The0ldM0nk/Locator2/Pictures/Pro Mini Soldered.jpg

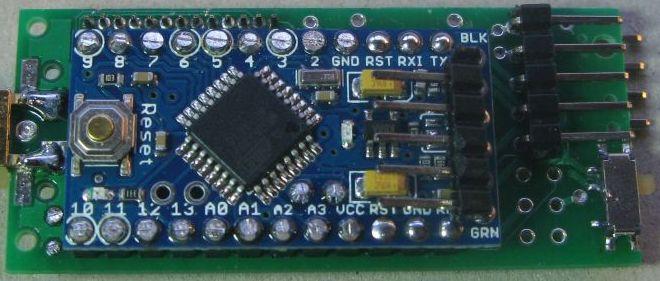
Pictures/Pro Mini Soldered.jpg
