The0ldM0nk/Locator2/Pictures/IMG_0867.JPG

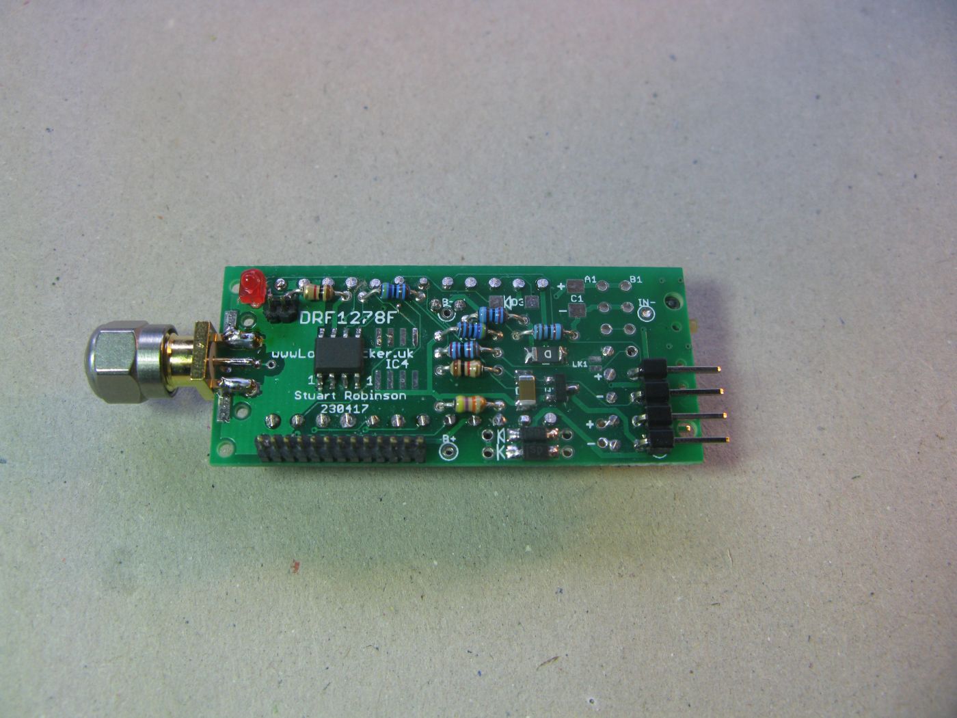
Pictures/IMG_0867.JPG
