The0ldM0nk/Locator2/Pictures/5 pin power header.jpg

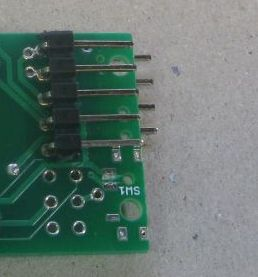
Pictures/5 pin power header.jpg
