The0ldM0nk/Locator2/Pictures/20x4 LCD Display Reduced.jpg

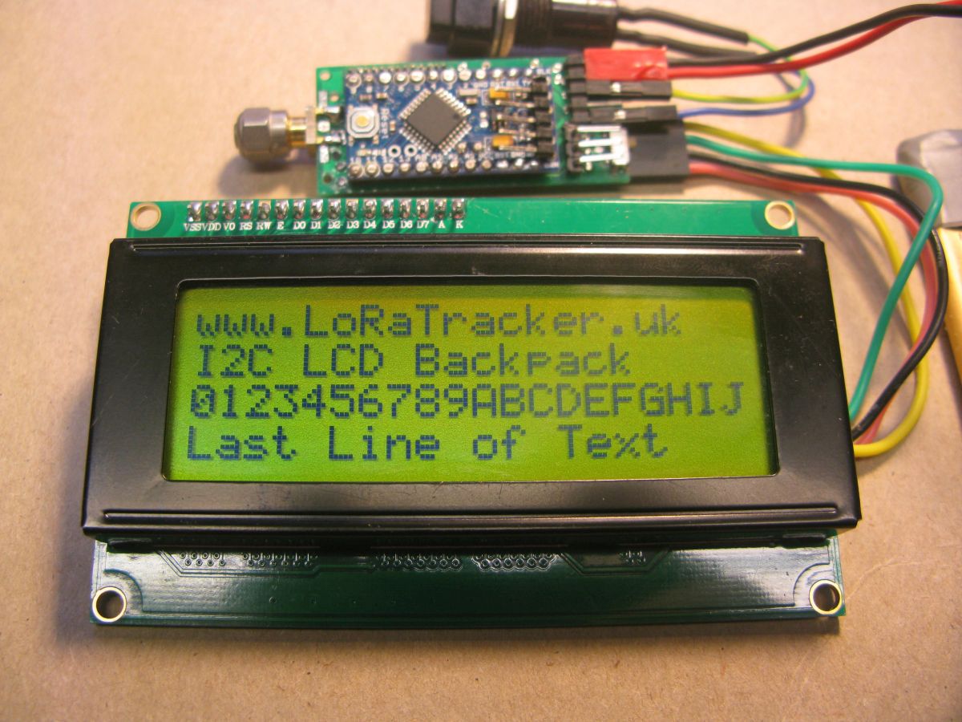
Pictures/20x4 LCD Display Reduced.jpg
