The0ldM0nk/Locator2/Pictures/GPS Connection.jpg

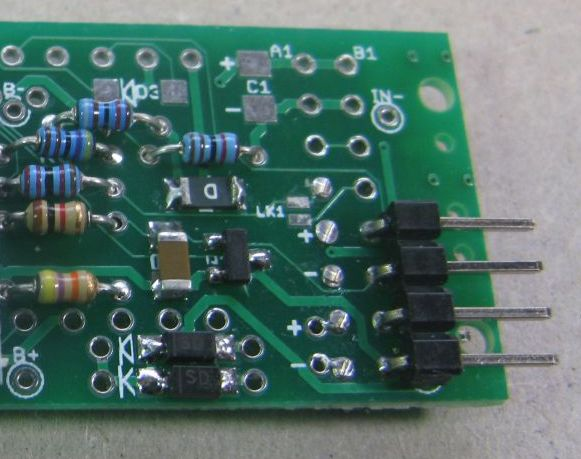
Pictures/GPS Connection.jpg
