The0ldM0nk/Locator2/Pictures/GPS header.jpg

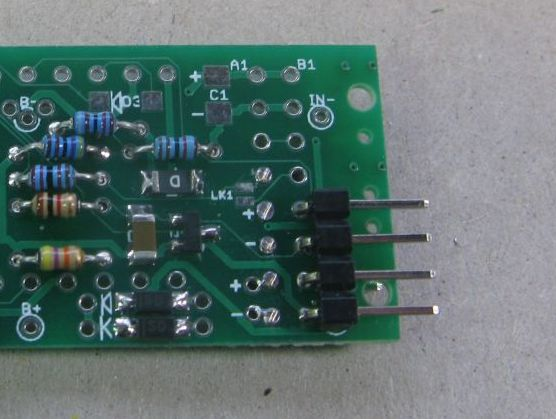
Pictures/GPS header.jpg
