The0ldM0nk/Locator2/Pictures/IMG_0831.JPG

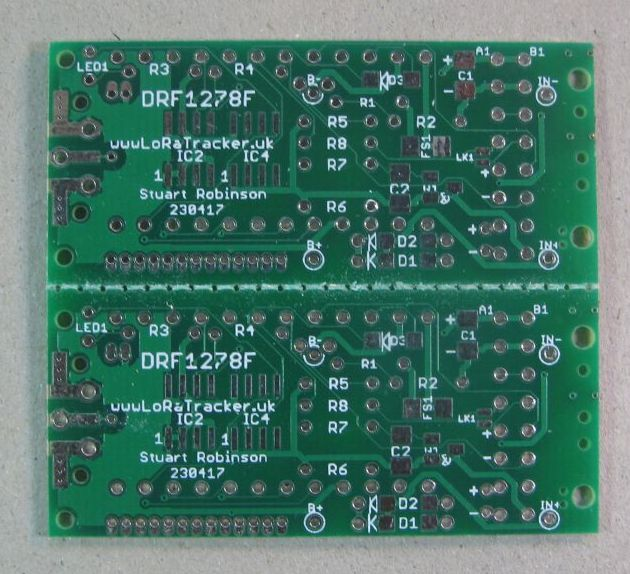
Pictures/IMG_0831.JPG
