The0ldM0nk/Locator2/Pictures/IMG_0835.JPG

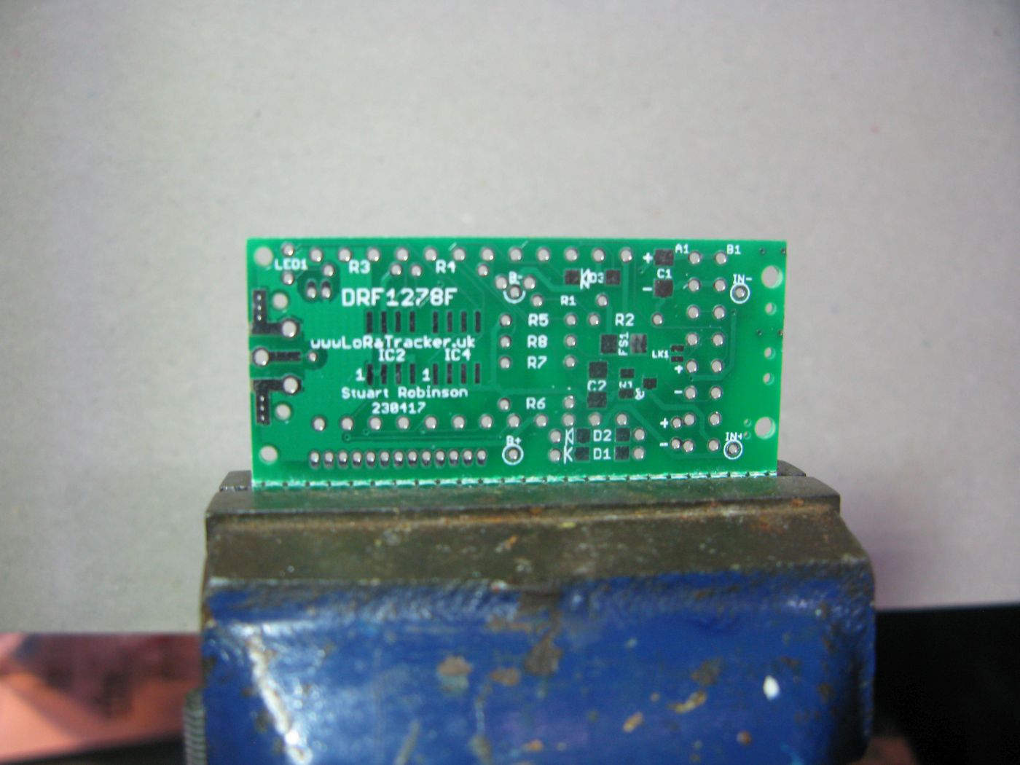
Pictures/IMG_0835.JPG
