The0ldM0nk/Locator2/Pictures/IMG_0836.JPG

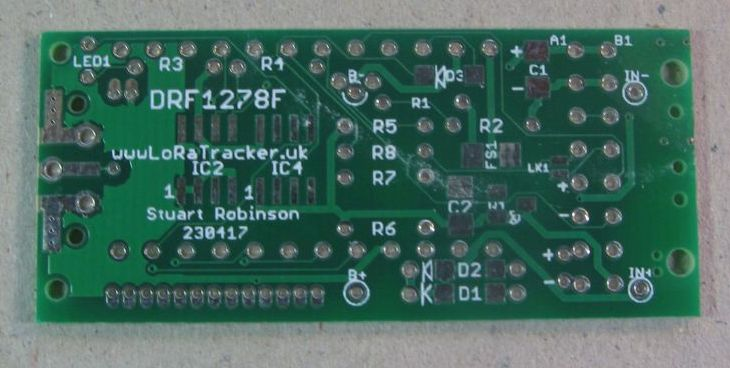
Pictures/IMG_0836.JPG
