The0ldM0nk/Locator2/Pictures/IMG_0838.JPG

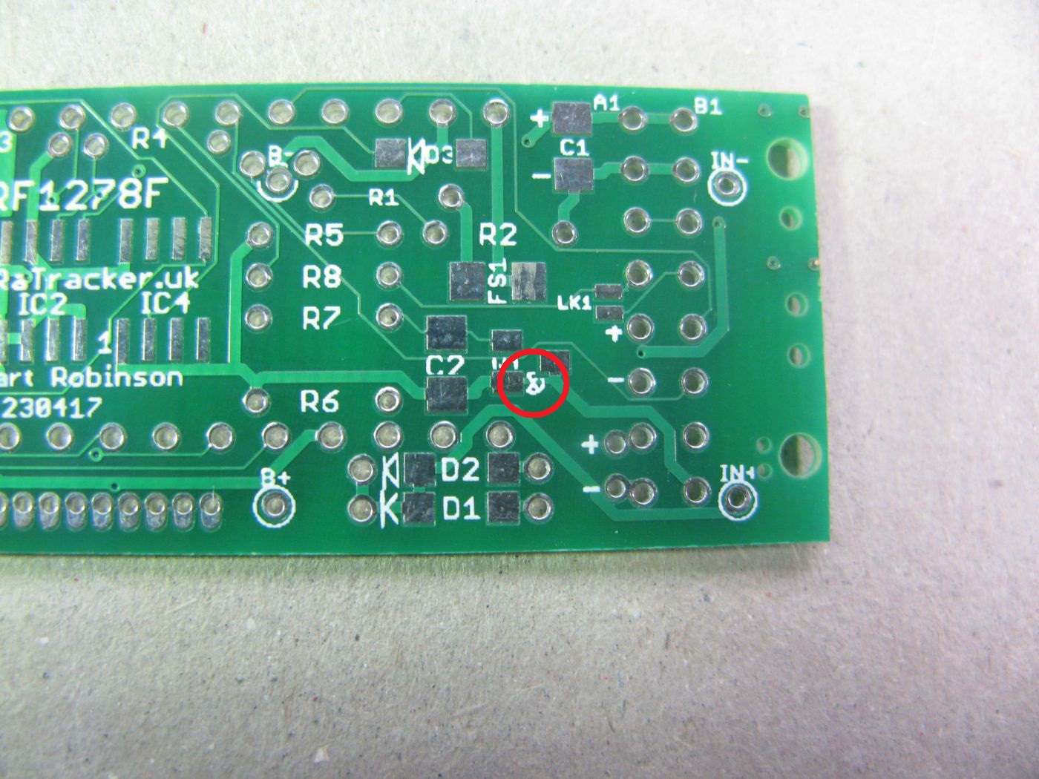
Pictures/IMG_0838.JPG
