The0ldM0nk/Locator2/Pictures/IMG_0840.JPG

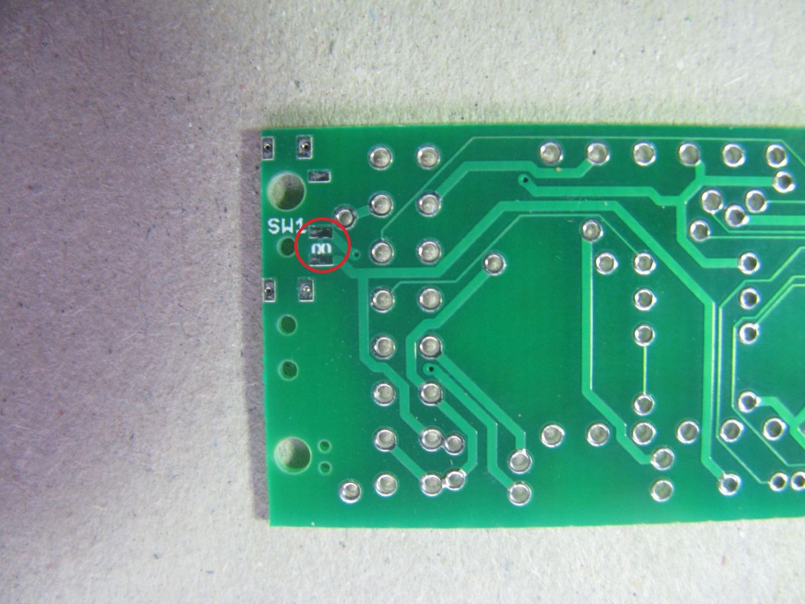
Pictures/IMG_0840.JPG
