The0ldM0nk/Locator2/Pictures/IMG_0843.JPG

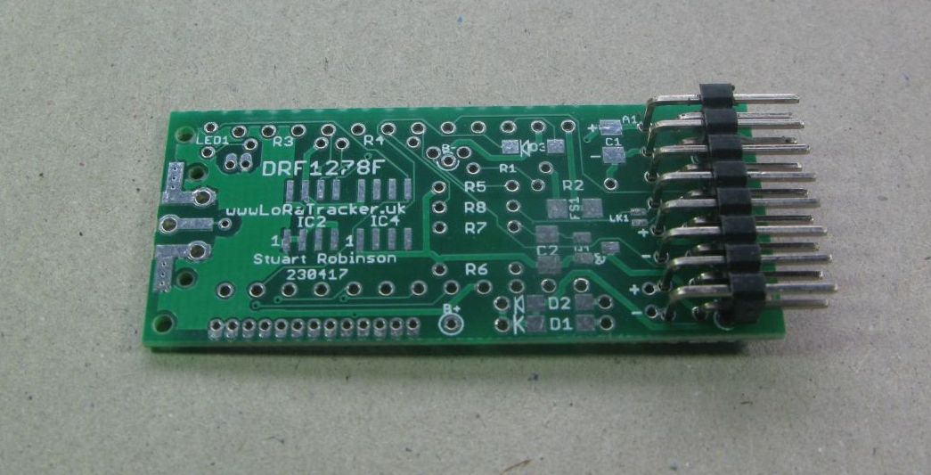
Pictures/IMG_0843.JPG
