The0ldM0nk/Locator2/Pictures/IMG_0844.JPG

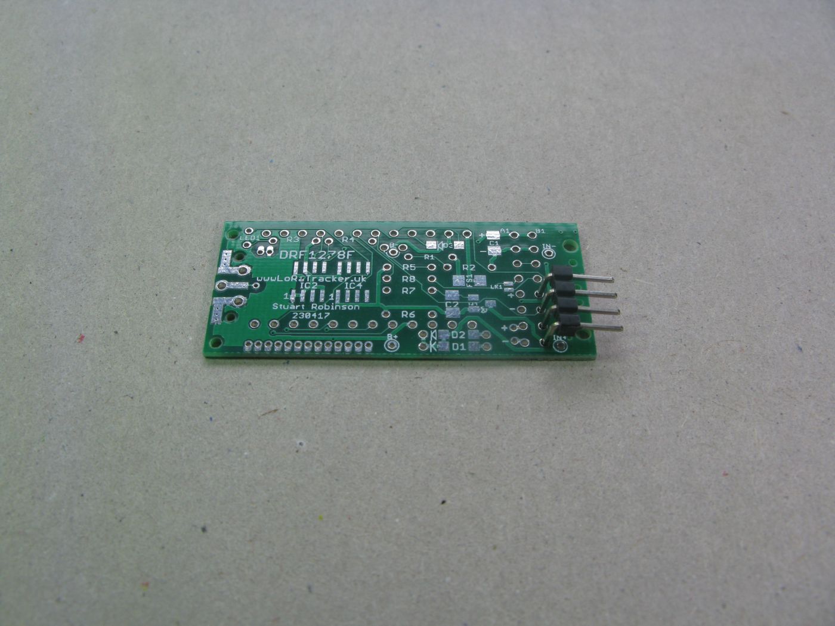
Pictures/IMG_0844.JPG
