The0ldM0nk/Locator2/Pictures/IMG_0846.JPG

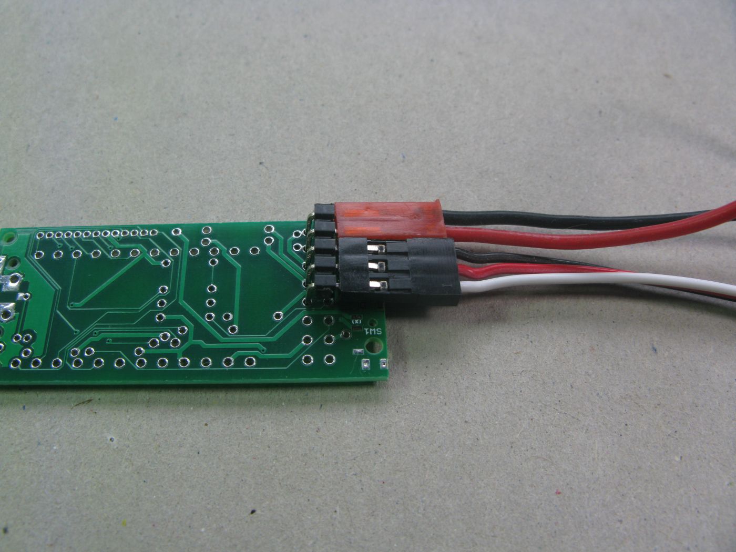
Pictures/IMG_0846.JPG
