The0ldM0nk/Locator2/Pictures/IMG_0847.JPG

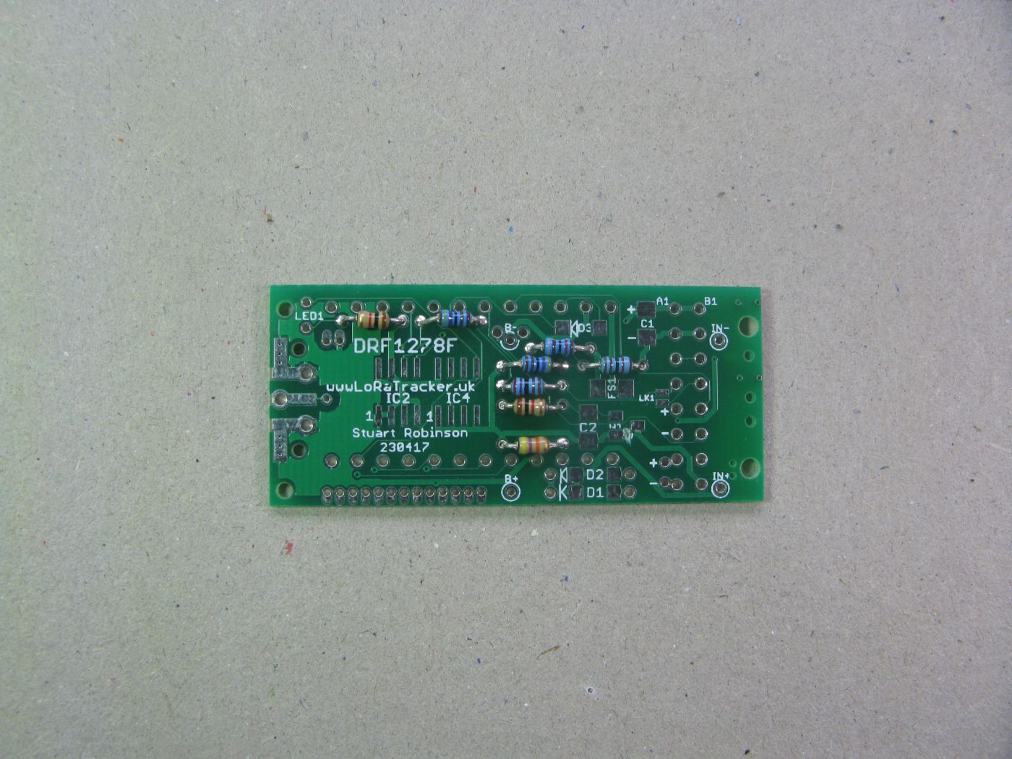
Pictures/IMG_0847.JPG
