The0ldM0nk/Locator2/Pictures/IMG_0850.JPG

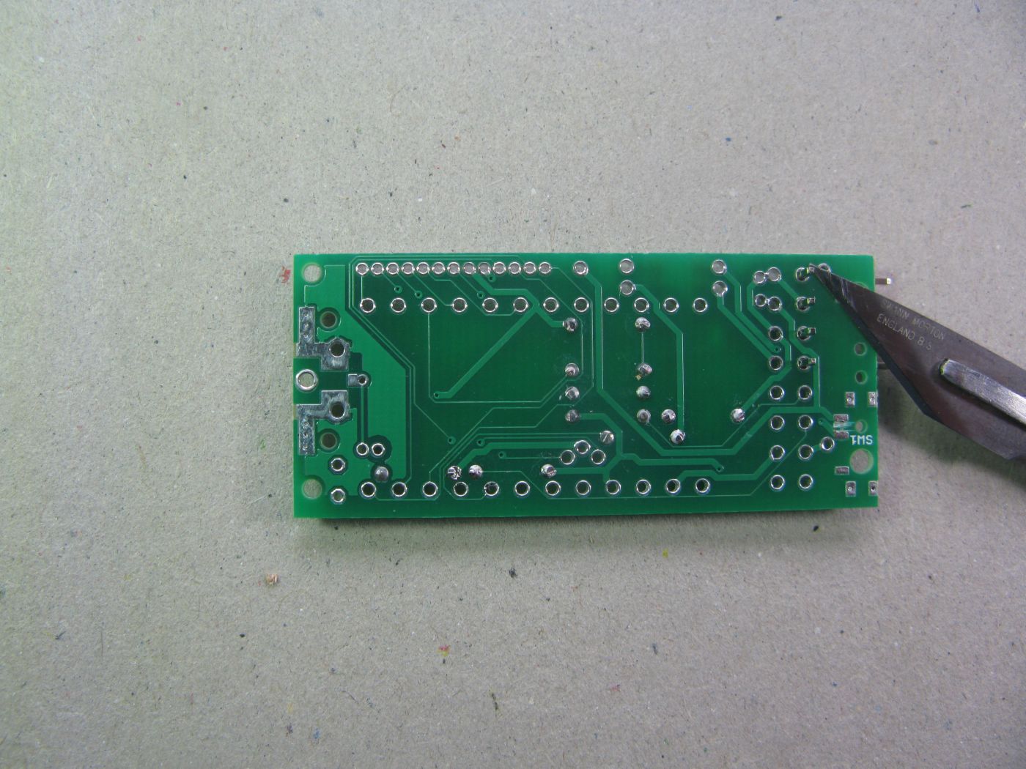
Pictures/IMG_0850.JPG
