The0ldM0nk/Locator2/Pictures/IMG_0851.JPG

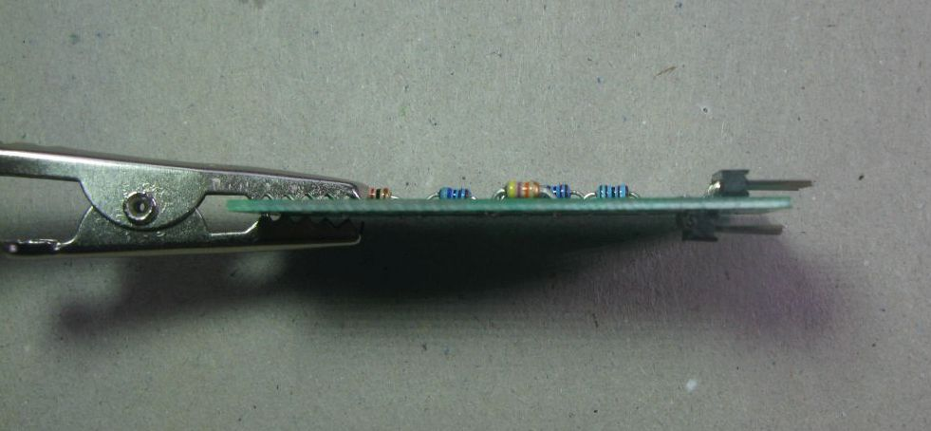
Pictures/IMG_0851.JPG
