The0ldM0nk/Locator2/Pictures/IMG_0853.JPG

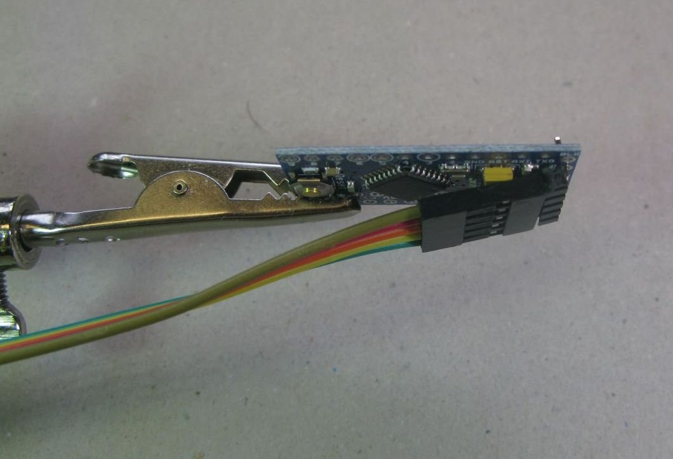
Pictures/IMG_0853.JPG
