The0ldM0nk/Locator2/Pictures/IMG_0857.JPG

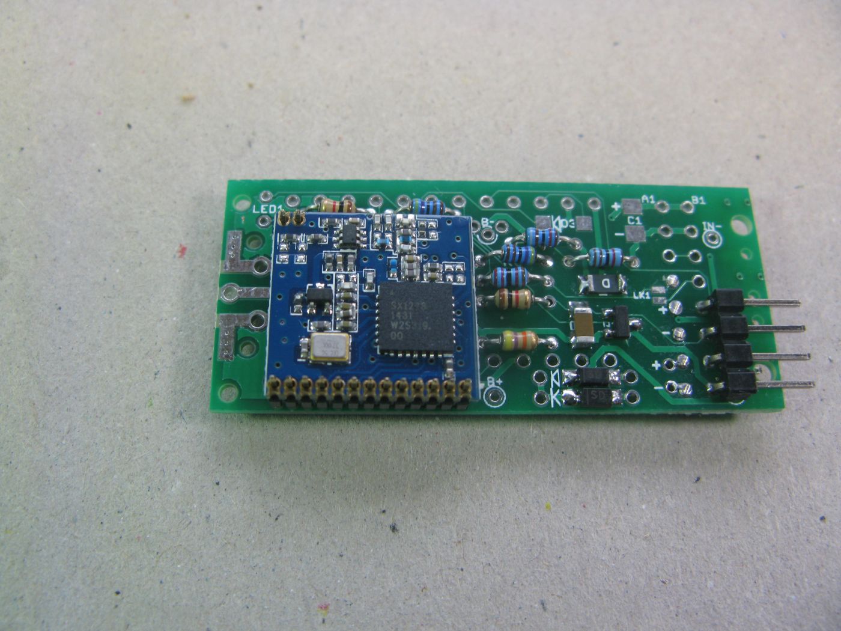
Pictures/IMG_0857.JPG
