The0ldM0nk/Locator2/Pictures/IMG_0859.JPG

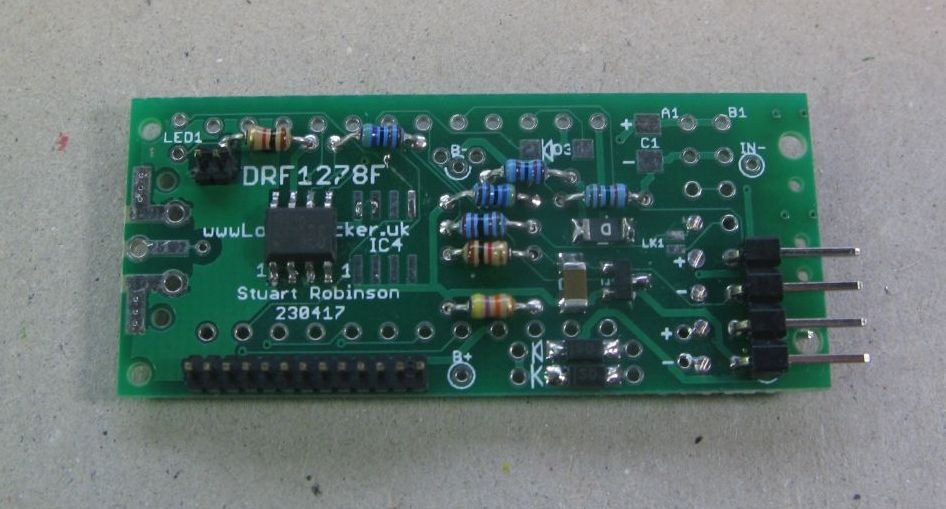
Pictures/IMG_0859.JPG
