The0ldM0nk/Locator2/Pictures/IMG_0860.JPG

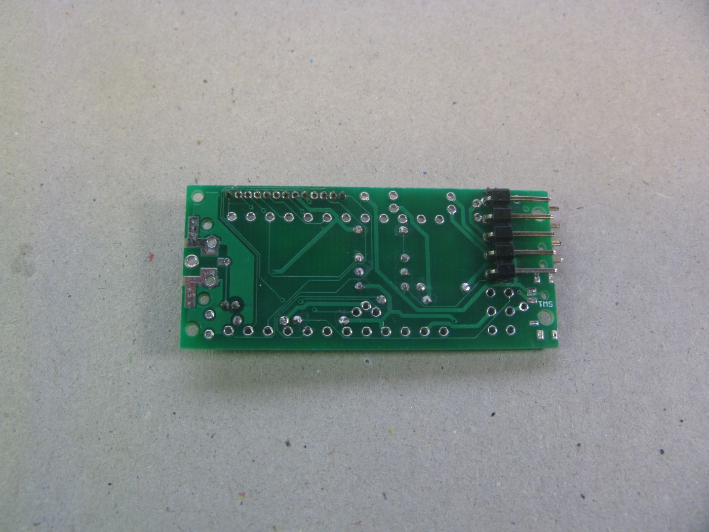
Pictures/IMG_0860.JPG
