The0ldM0nk/Locator2/Pictures/IMG_0861.JPG

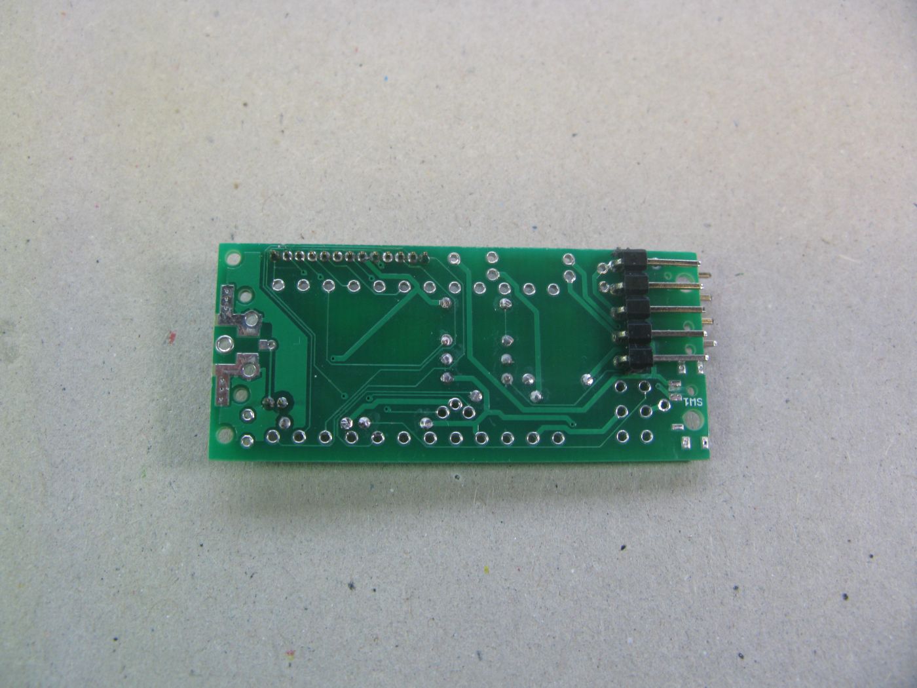
Pictures/IMG_0861.JPG
