The0ldM0nk/Locator2/Pictures/IMG_0864.JPG

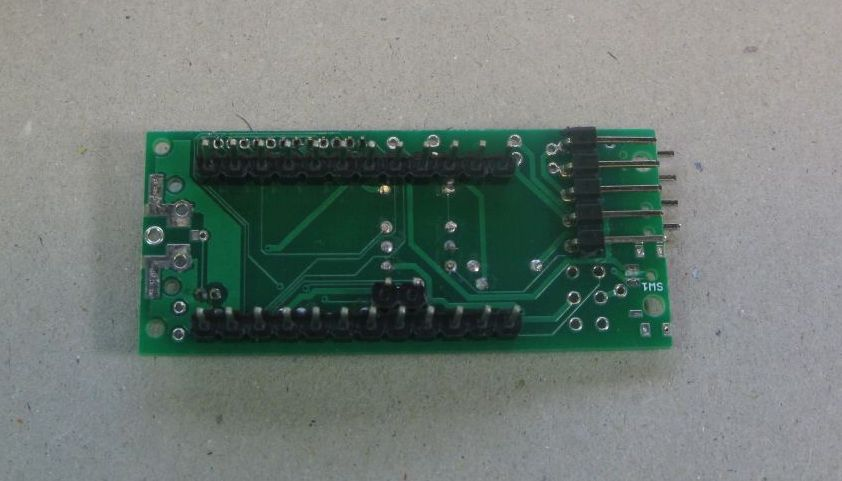
Pictures/IMG_0864.JPG
