The0ldM0nk/Locator2/Pictures/IMG_0865.JPG

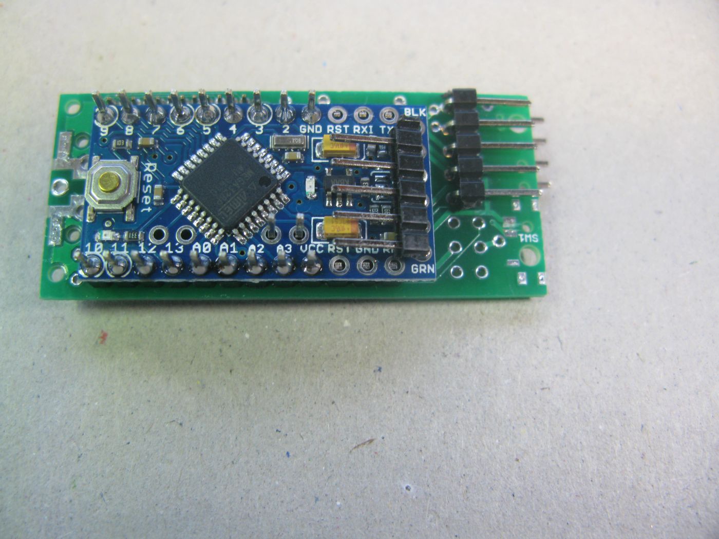
Pictures/IMG_0865.JPG
