The0ldM0nk/Locator2/Pictures/IMG_0869.JPG

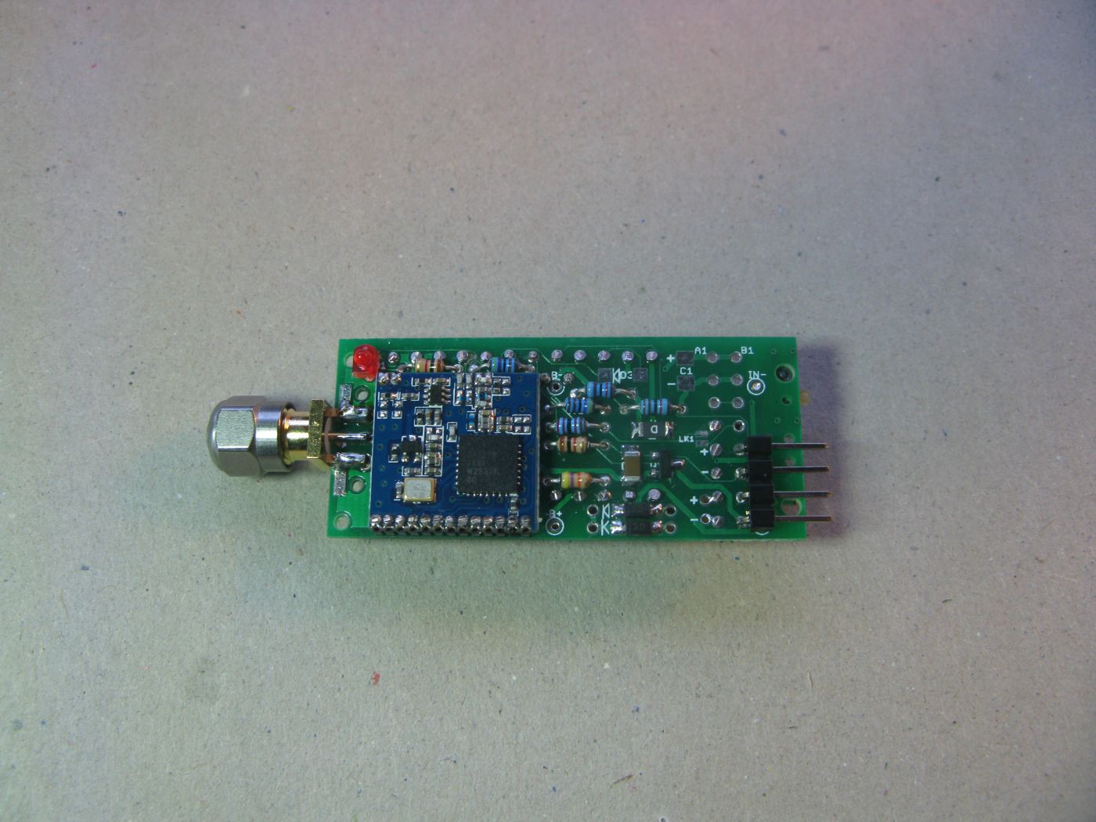
Pictures/IMG_0869.JPG
