The0ldM0nk/Locator2/Pictures/IMG_0870.JPG

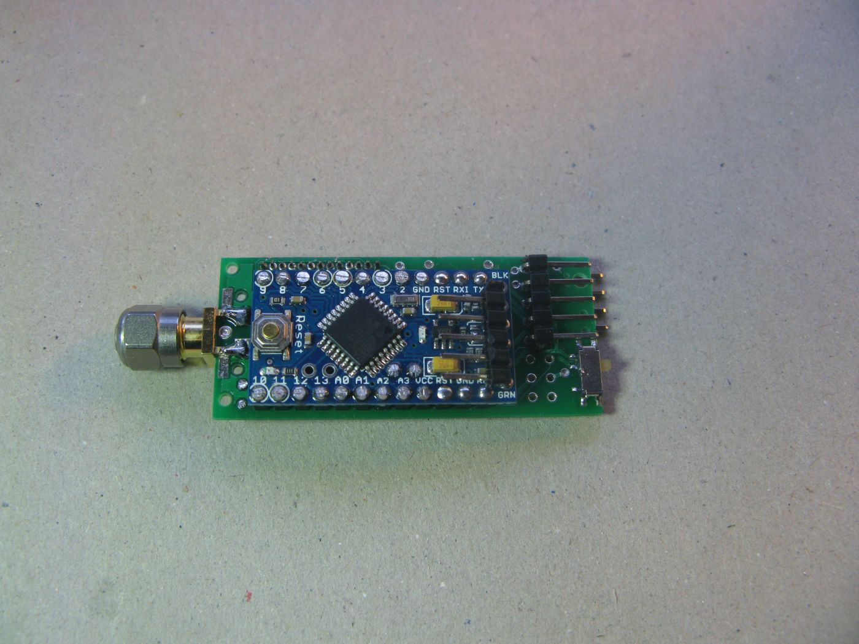
Pictures/IMG_0870.JPG
