The0ldM0nk/Locator2/Pictures/IMG_0953.JPG

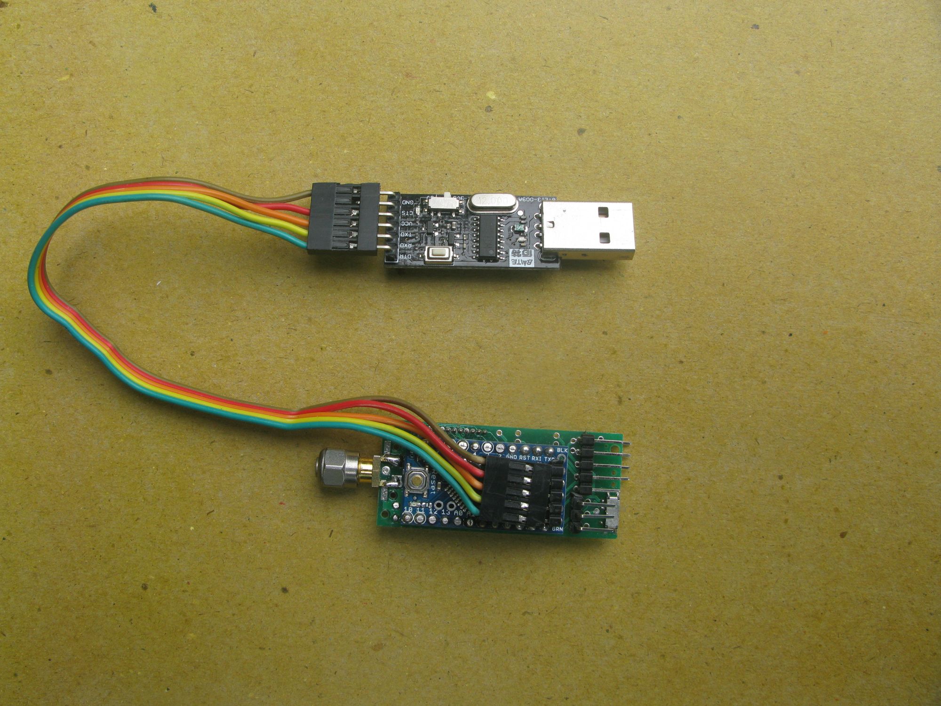
Pictures/IMG_0953.JPG
