The0ldM0nk/Locator2/Pictures/IMG_0956.JPG

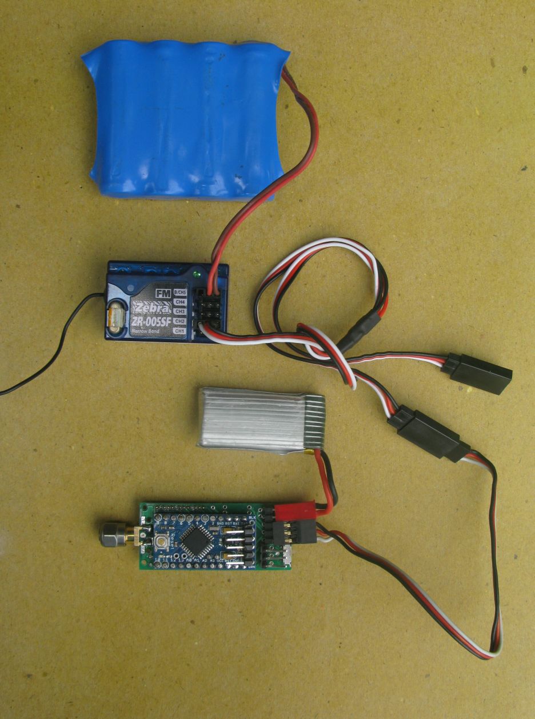
Pictures/IMG_0956.JPG
