The0ldM0nk/Locator2/Pictures/IMG_0960.JPG

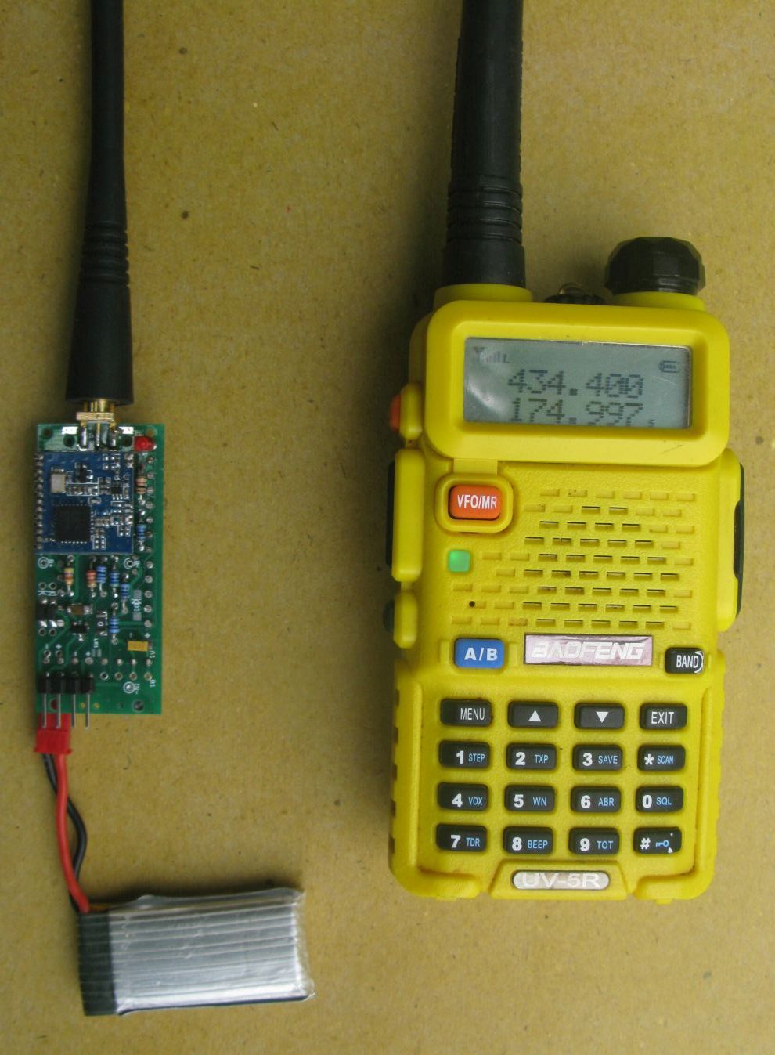
Pictures/IMG_0960.JPG
