The0ldM0nk/Locator2/Pictures/lcd_20x4_Reduced.jpg

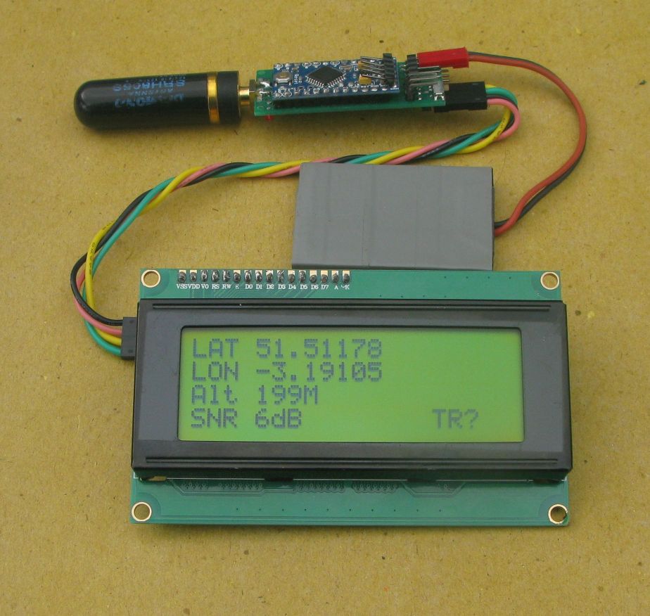
Pictures/lcd_20x4_Reduced.jpg
