The0ldM0nk/Locator2/Pictures/Locator2 230417.jpg

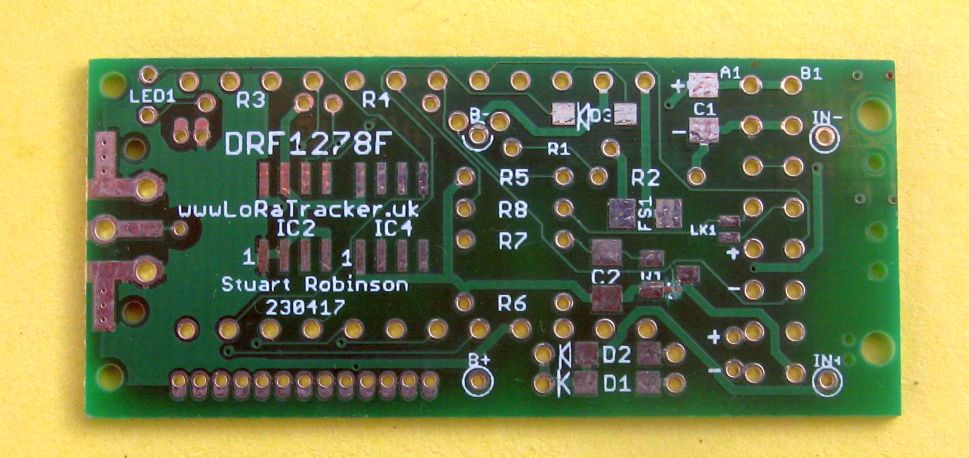
Pictures/Locator2 230417.jpg
