The0ldM0nk/Locator2/Pictures/Locator2 270617 Links2.jpg

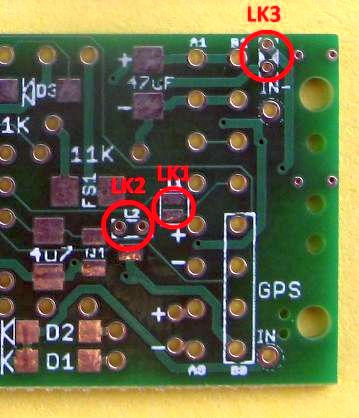
Pictures/Locator2 270617 Links2.jpg
