The0ldM0nk/Locator2/Pictures/Locator2 270617 Links.jpg

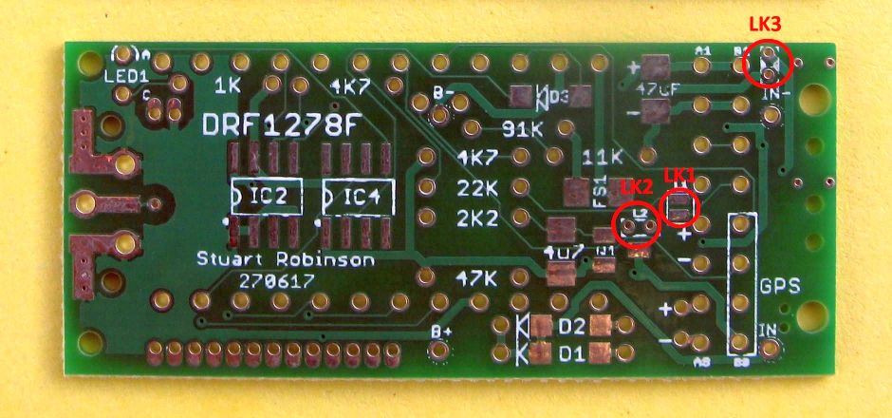
Pictures/Locator2 270617 Links.jpg
