The0ldM0nk/Locator2/Pictures/Locator2 with GPS Reduced.jpg

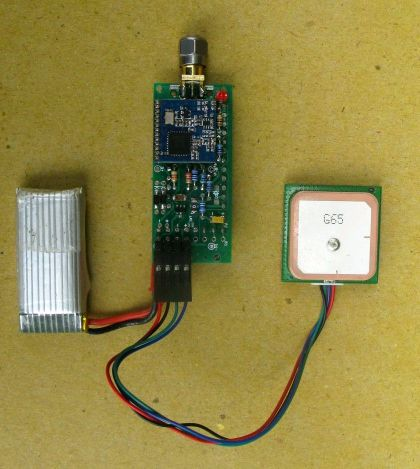
Pictures/Locator2 with GPS Reduced.jpg
