The0ldM0nk/Locator2/Pictures/Locator2_SD1306.jpg

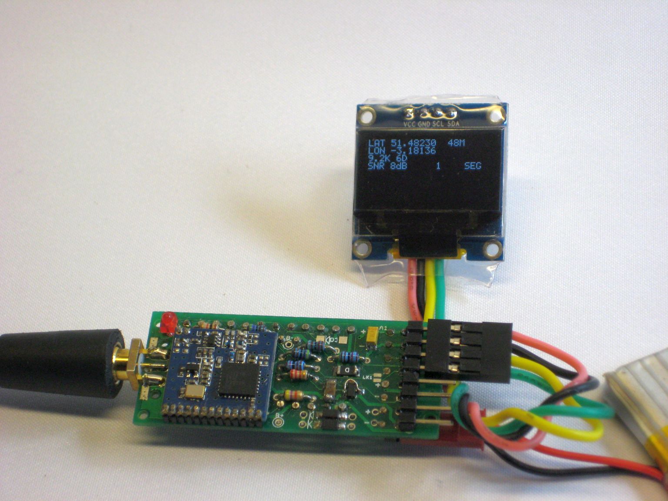
Pictures/Locator2_SD1306.jpg
