The0ldM0nk/Locator2/Pictures/PCF8574 Connection Reduced.jpg

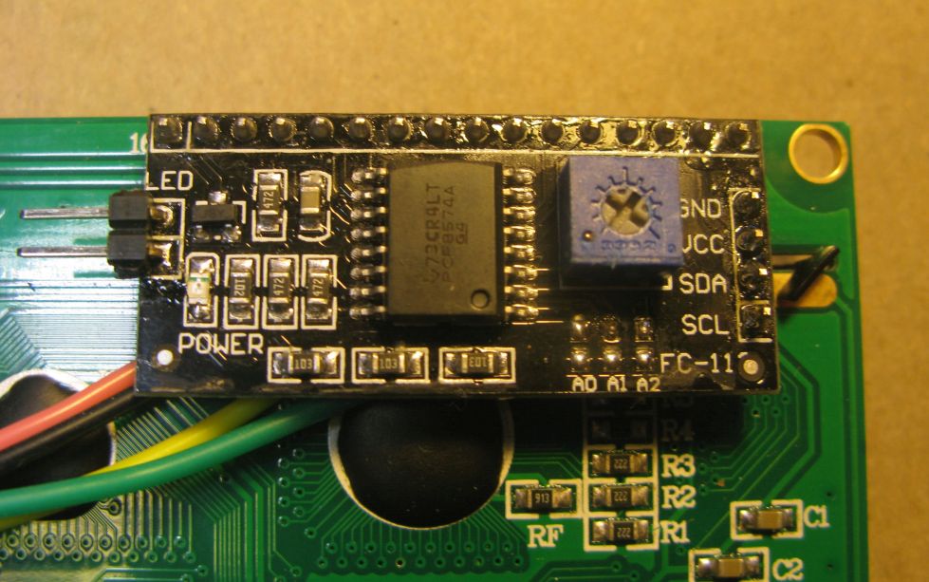
Pictures/PCF8574 Connection Reduced.jpg
