The0ldM0nk/Locator2/Pictures/RC Pulse Check.JPG

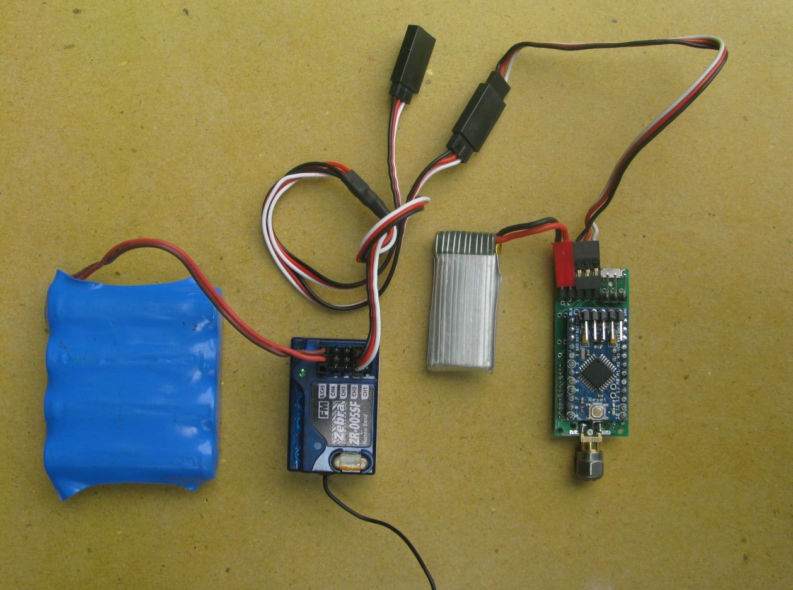
Pictures/RC Pulse Check.JPG
