The0ldM0nk/Locator2/Pictures/SD1306 Connection Reduced.jpg

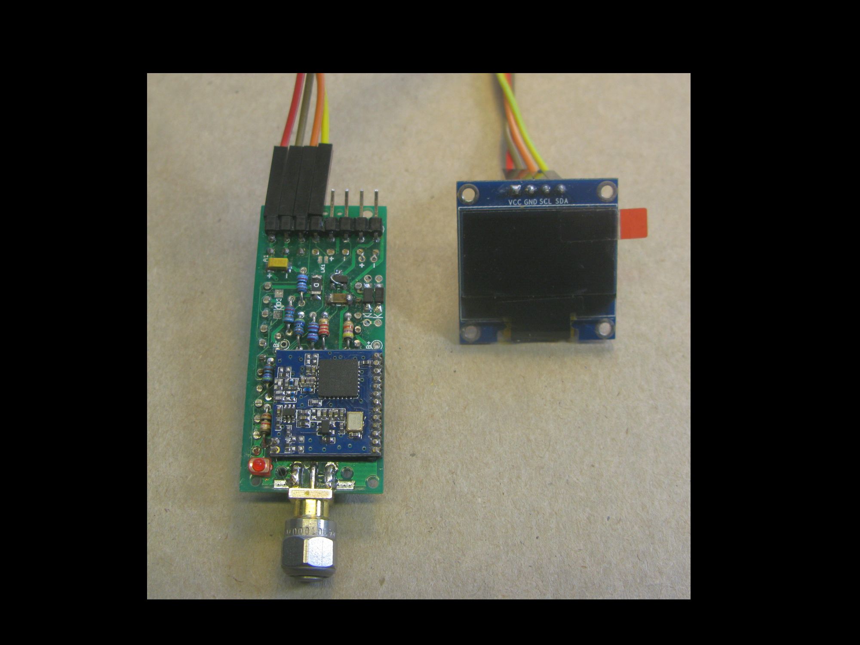
Pictures/SD1306 Connection Reduced.jpg
