The0ldM0nk/Locator2/Pictures/Switch Connection Reduced.jpg

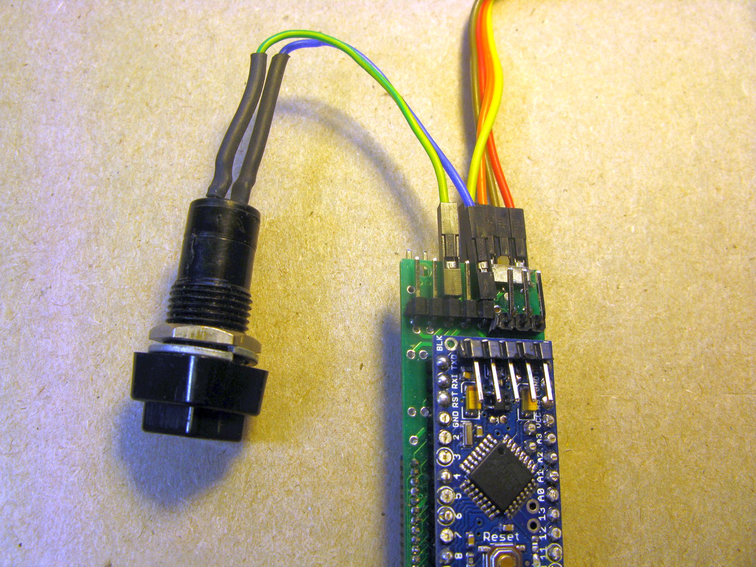
Pictures/Switch Connection Reduced.jpg
