The0ldM0nk/Locator2/Parts/Locator2 Kit Contents.xls

Part | Value | Kit Q | Notes
D1,D2 | B0520 | 4
Q1 | IRLML6402 | 2
R1 | 91K | 2
R2 | 11K | 2
R3 | 1K | 4
R4,R5 | 4K7 | 4
R6 | 47K | 4
R7 | 2K2 | 2
R8 | 22K | 2
C1 | 47uF | 2 | 1206 Tantalum, polarity marked, brown band is +V
C2 | 4u7 | 2 | 1206 Ceramic
IC1 | DRF1278F | 2 | PCB module
IC2 | MB85RC16PNF | 2 | I2C FRAM SOIC8
FS1 | 250mA PolyFuse | 2 | 1206 – Marked as 0
Switch | Small SMT | 2
Antenna Socket | U.Fl SMT Socket | 1
Antenna Socket | ANT – Edge SMA | 1
LED1 | Red 1.8mm | 2
CHARGE1 | Lithium Charger PCB | 2 | Needs resistor change
SMT Resistor | 6K8 | 2 | To modify charger PCB, 0603
PCB | 2 tracker PCBs per board. | 1
Battery Lead | JST Silicone Battery Lead | 2
Servo Lead | 150mm | 1
0.1” Double Angled Pin Header | 0.1" 2 row Angled header (8 way) | 1 | For Receiver PCB
0.05” Straight Pin Header | 0.05” pin headers (30 Way) | 1 | For DRF1278F
0.1” Straight Pin Header | 0.1" Straight pin headers (40 way) | 2.5 | ProMini Mount + CON1
0.1” Angled Pin Header | 0.1" Angled headers (40 way) | 1 | For Pro Mini program connector, GPS
