The0ldM0nk/Locator2/Parts/LoRaTracker Locator2 230417.xls

Part | Value | Device | Package | Notes
ANT1 |  | SMA Edge Connector | SMA | Optional
ANT2 |  | U.FL Connector | U.FL | Optional
C1 | 10uF | Capacitor - Ceramic | C1206 | Optional
C2 | 4u7 | Capacitor - Ceramic | C1206 | Optional – For GPS Power Switch
CHARGER |  | Lithium Charger PCB | PCB Module | Optional
CONA | 8 Way 1 Row | Pin header | 0.1” header | Single row, dual row, straight or angled
CONB | 8 Way 1 Row | Pin header | 0.1” header | Single row, dual row, straight or angled
CONBAT | 2MMJST | 2mm JST | 2mm JST | Optional battery connector
D1 | BAT51 | Diode | Wired Axial | Option
D1A | B0520 | Diode | SOD123
D2 | BAT51 | Diode | Wired Axial | Option
D2A | B0520 | Diode | SOD123
D3 | B0520 | Diode | SOD123 | Optional for Watchdog
FS1 | 250mA | PolyFuse | 1206
IC1 | DRF1278F | DRF1278F | PCB module
IC2 | MB85RC16PNF | FRAM | SOIC8 | Optional – not currently used
IC3 | 8Mhz 3.3V | ARDUINO Pro Mini | PCB Module
IC4 | WATCHDOG | 12F1840_SOIC | SOIC8 | Optional
LED1 | Red | LED | 1.8mm LED
LK1 |  | Link | SMT PADS
Q1 | IRLML6402 | MOSFET | SOT23 | Optional – For GPS Power Switch
R1 | 91K | Resistor | 125mW
R2 | 11K | Resistor | 125mW
R3 | 1K | Resistor | 125mW
R4 | 4K7 | Resistor | 125mW
R5 | 4K7 | Resistor | 125mW
R6 | 47K | Resistor | 125mW | Optional – For GPS Power Switch
R7 | 2K2 | Resistor | 125mW | Optional – For GPS Power Switch
R8 | 22K | Resistor | 125mW
SW1 | SMT SWITCH | Switch | SMT | Optional
Header1 | 12 Way Vertical | Pin Header | 0.1” header | Not on schematic – fit to ProMini
Header2 | 12 Way Vertical | Pin Header | 0.1” header | Not on schematic – fit to ProMini
Header3 | 2 Way Vertical | Pin Header | 0.1” header | Not on schematic – fit to ProMini
Header4 | 5 Way Angled | Pin Header | 0.1” header | Not on schematic – fit to ProMini
Header5 | 13 Way Vertical | Pin Header | 0.05”header | Not on schematic – fit to DRF1278F
Header6 | 2 Way Vertical | Pin Header | 0.05”header | Not on schematic – fit to DRF1278F
Header6 | 2 Way 2 Row angled | Pin Header | 0.1” header | Not on schematic
CHARGE1 | Lithium Charger PCB | Module | Needs resistor change | Lithium charger module
R9 | 6K8 Resistor | Resistor | SMT 0603 | For Lithium charger module
PCB |  |  |  | 2 Trackers per board
Battery Lead | JST Silicone Battery Lead | Lead |  | 2 per kit
Servo Lead | 150mm | Lead |  | 1 per kit
