The0ldM0nk/Locator2/Schematic/Locator2 RFM9X 170917 Schematic.pdf

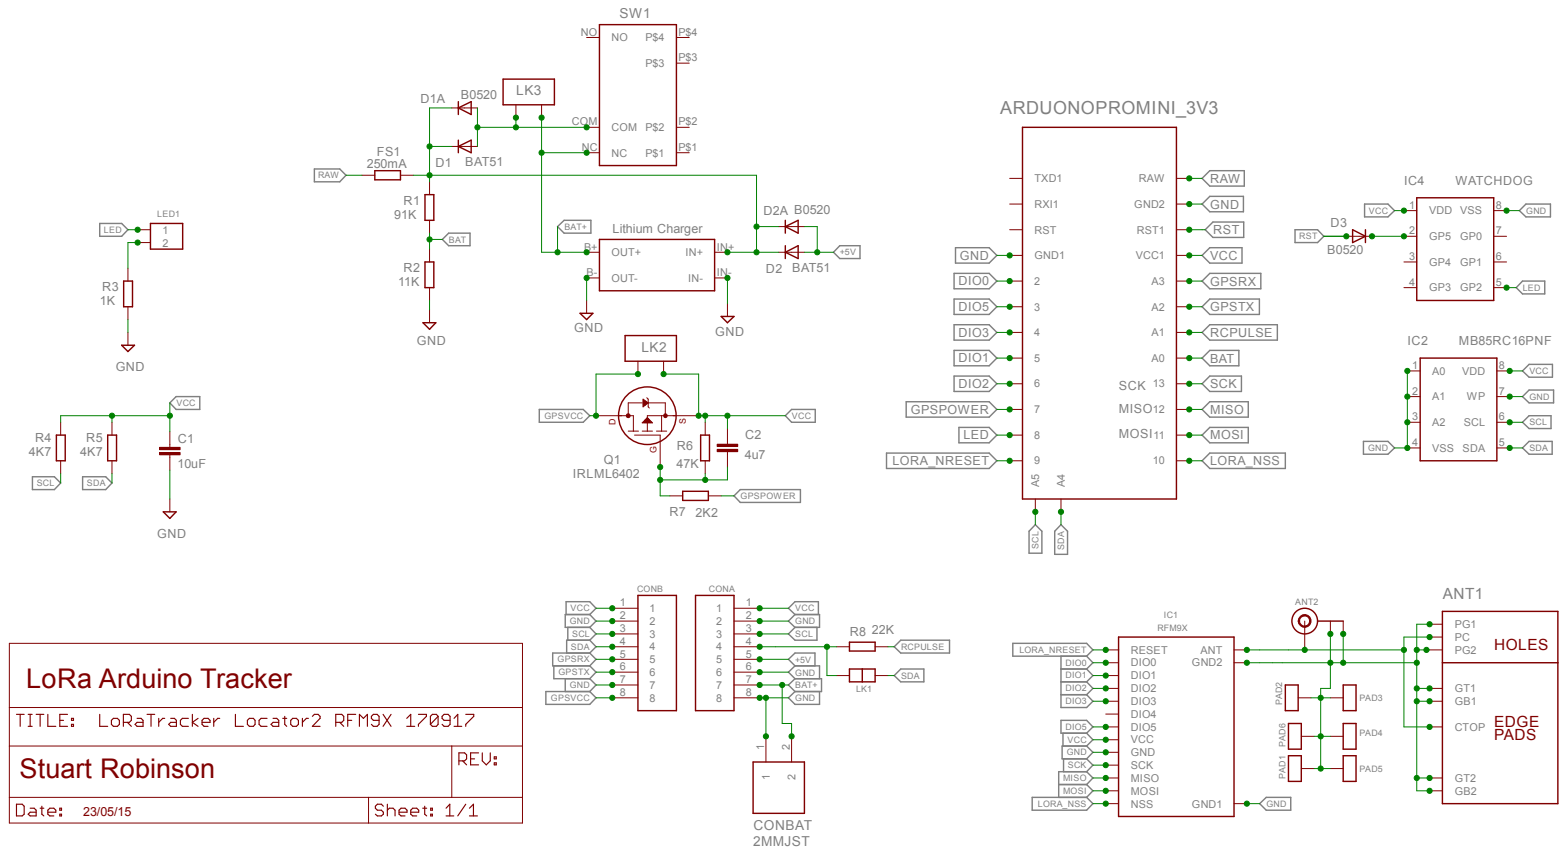
[picture p46: page 1]
