The0ldM0nk/Locator2/Schematic/Locator2 Schematic 270617.pdf

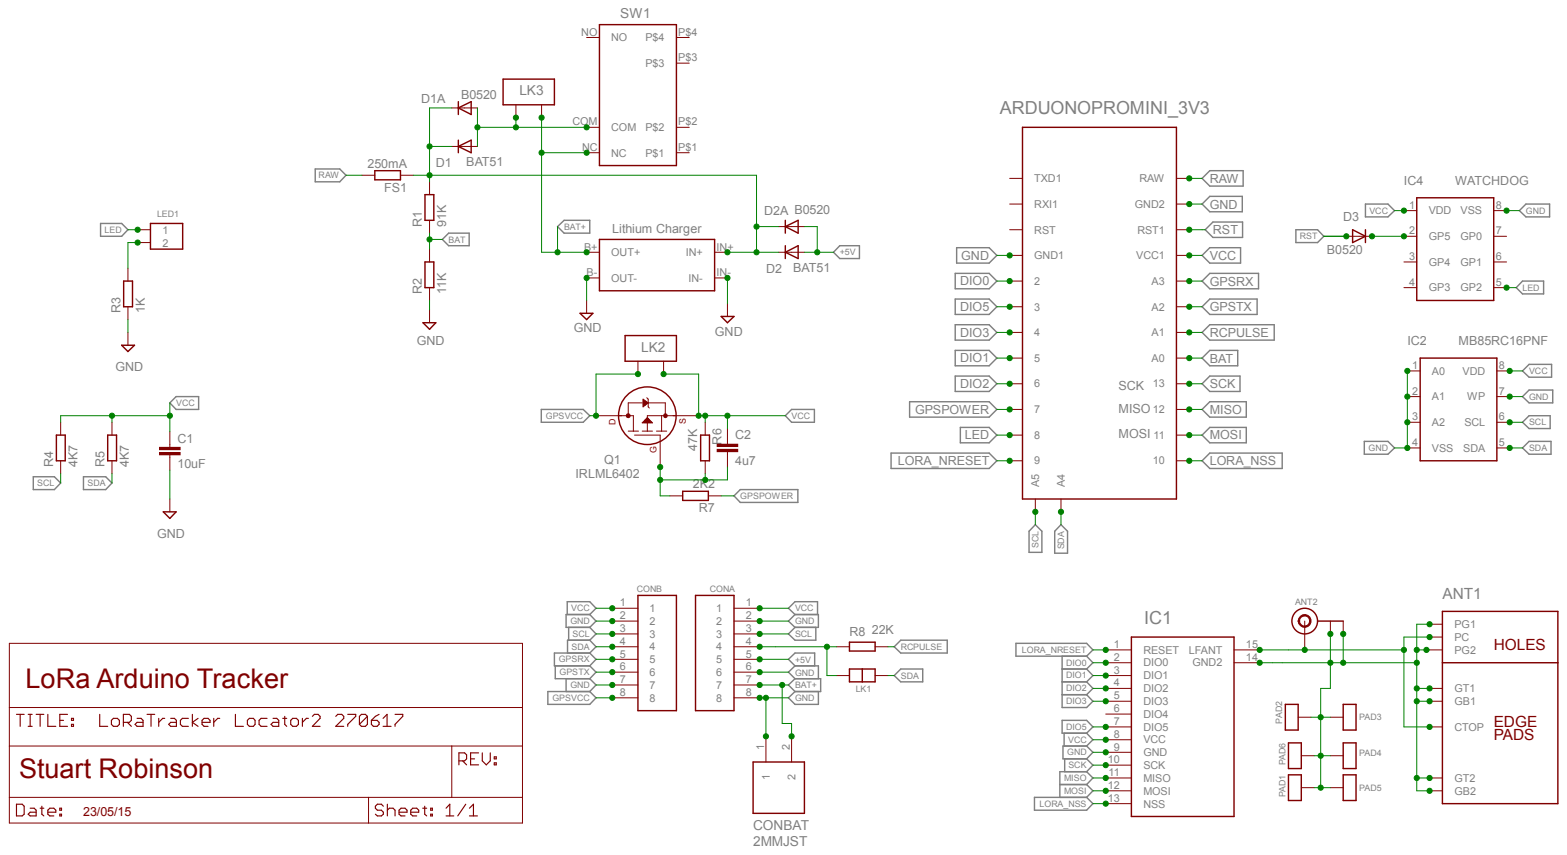
[picture p47: page 1]
