The0ldM0nk/Locator2/Schematic/Locator2 Schematic 230417.pdf

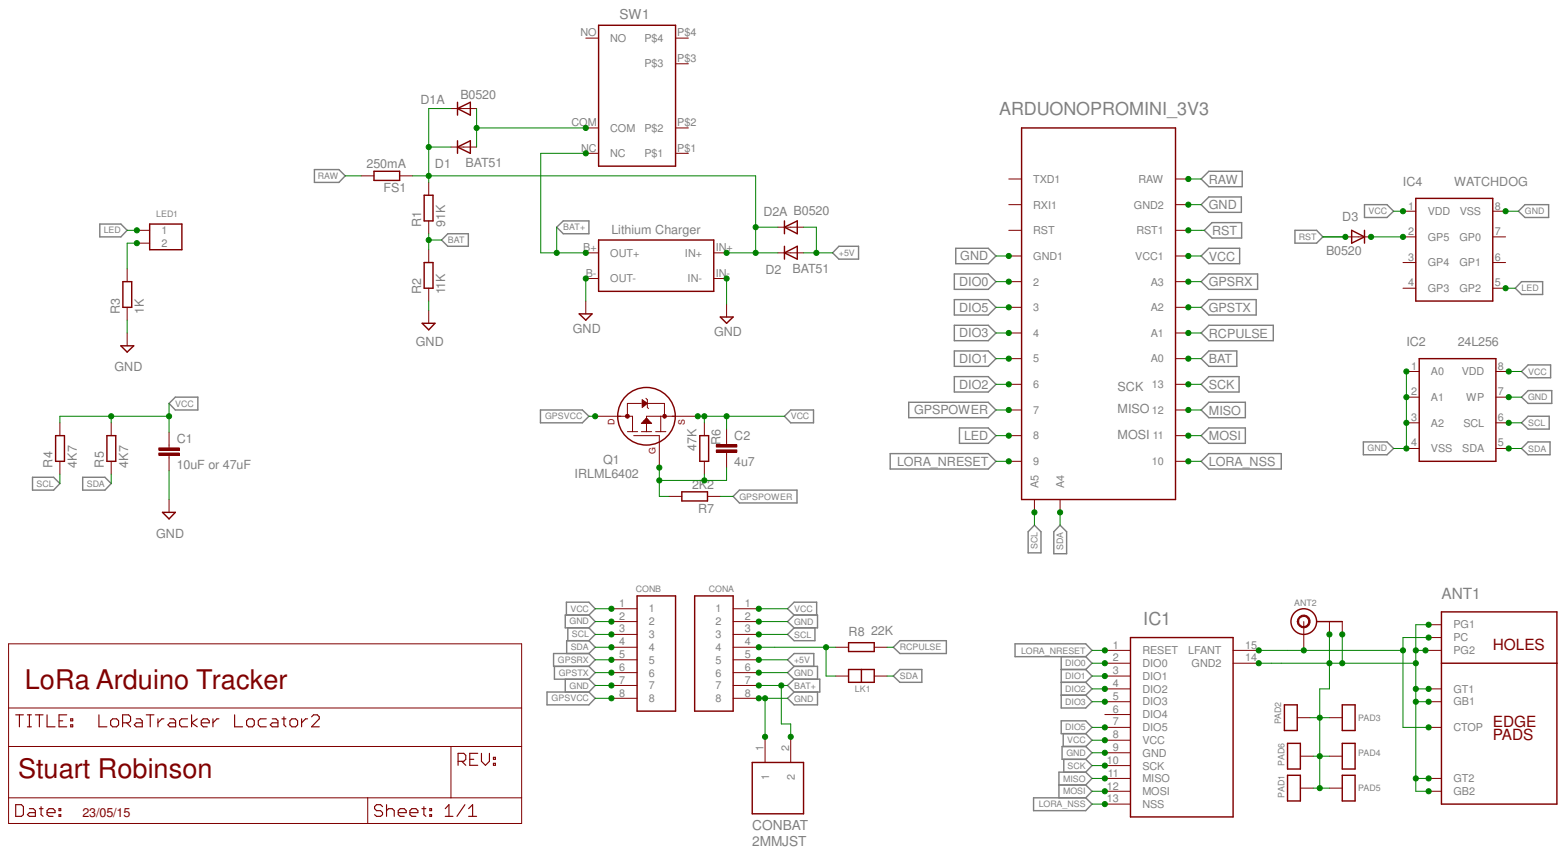
[picture p48: page 1]
