The0ldM0nk/Locator2/Board/Locator2 RFM9X 170917 PCB Names.pdf

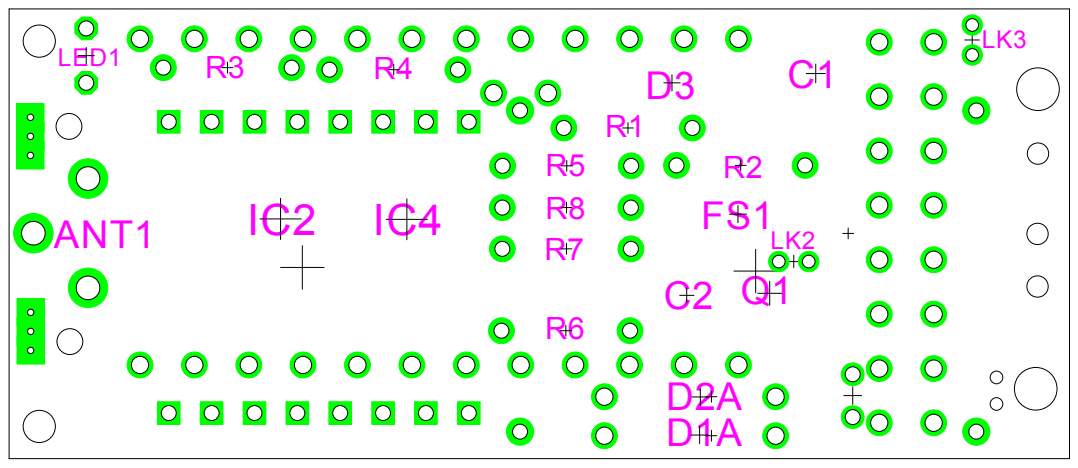
[picture p49: page 1]
