The0ldM0nk/Locator2/Board/Locator2 RFM9X 170917 PCB Values.pdf

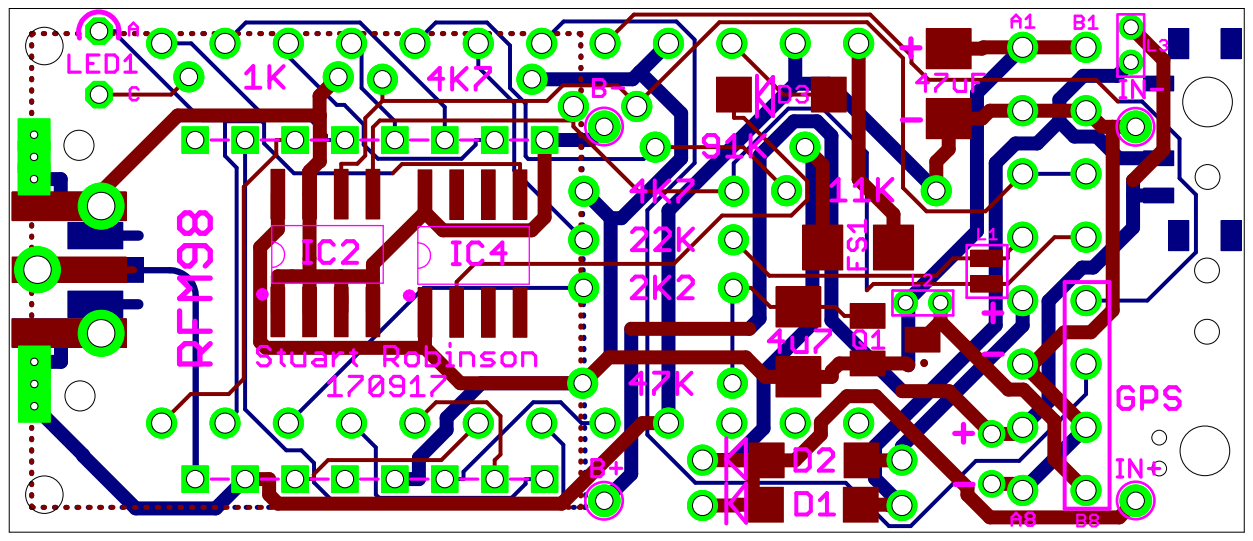
[picture p50: page 1]
