The0ldM0nk/Locator2/Board/Locator2 PCB Bottom 270617 .pdf

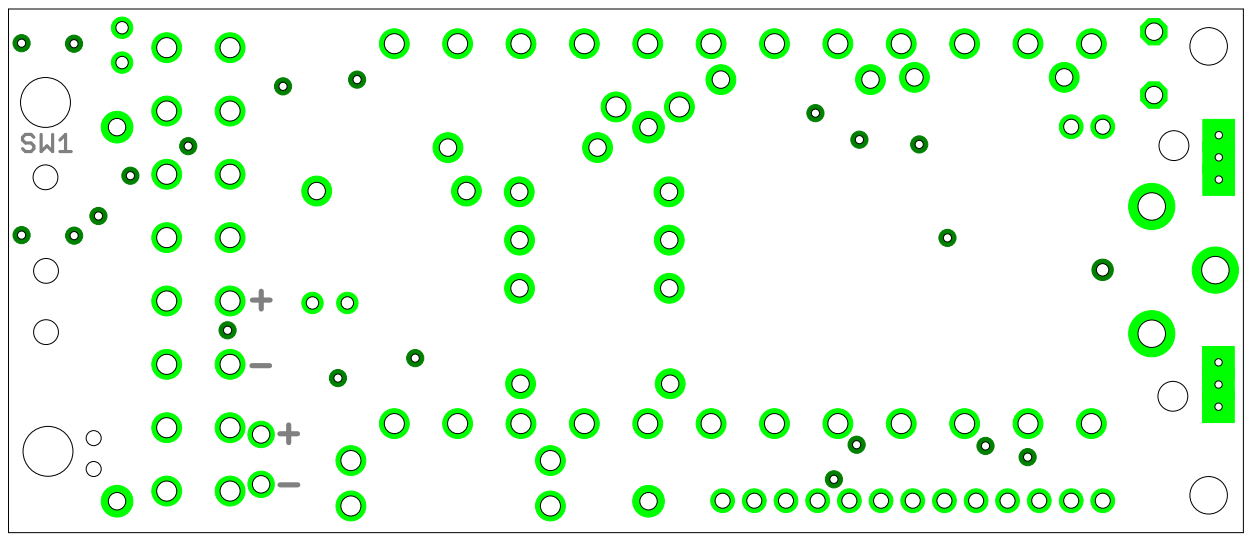
[picture p51: page 1]
