The0ldM0nk/Locator2/Board/Locator2 PCB TOP 270617 Names.pdf

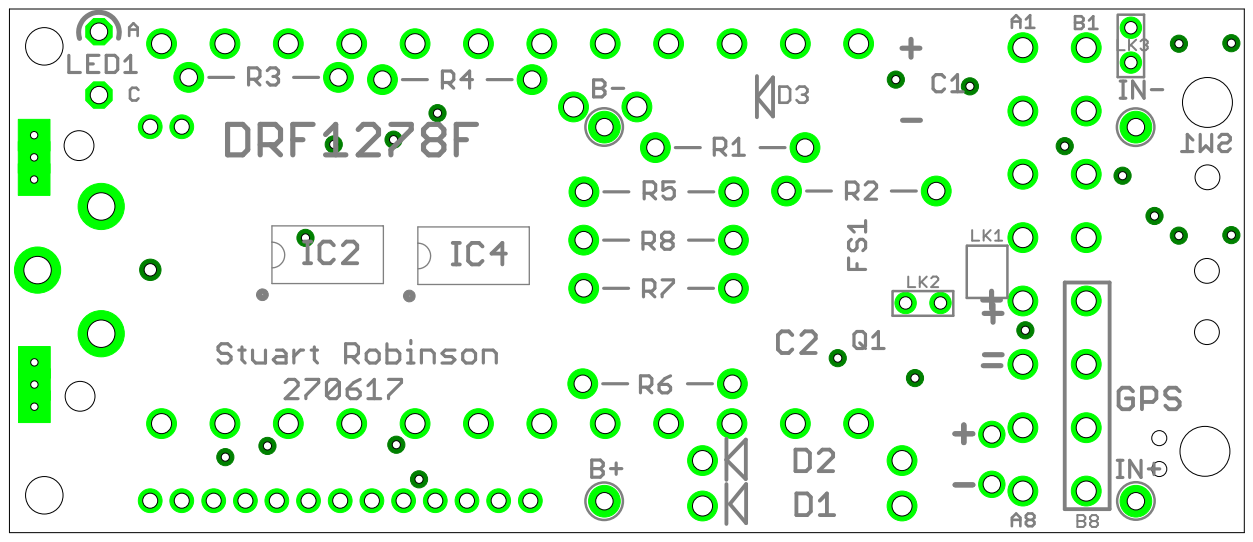
[picture p52: page 1]
