The0ldM0nk/Locator2/Board/Locator2 PCB Top 270617 Values.pdf

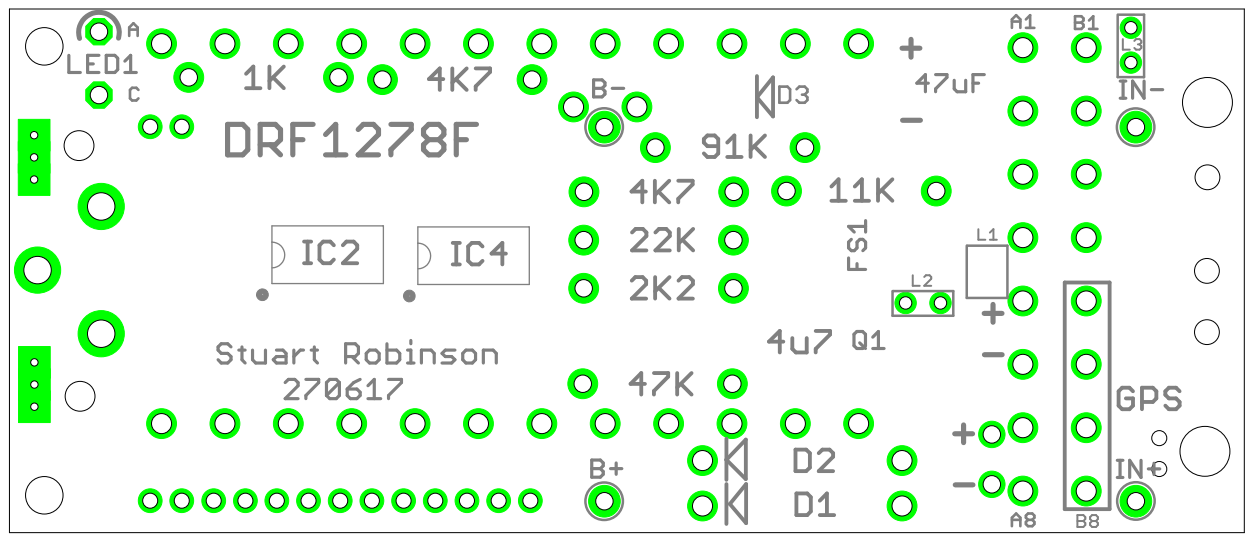
[picture p53: page 1]
