The0ldM0nk/Locator2/Board/Locator2 PCB Bottom 230417.pdf

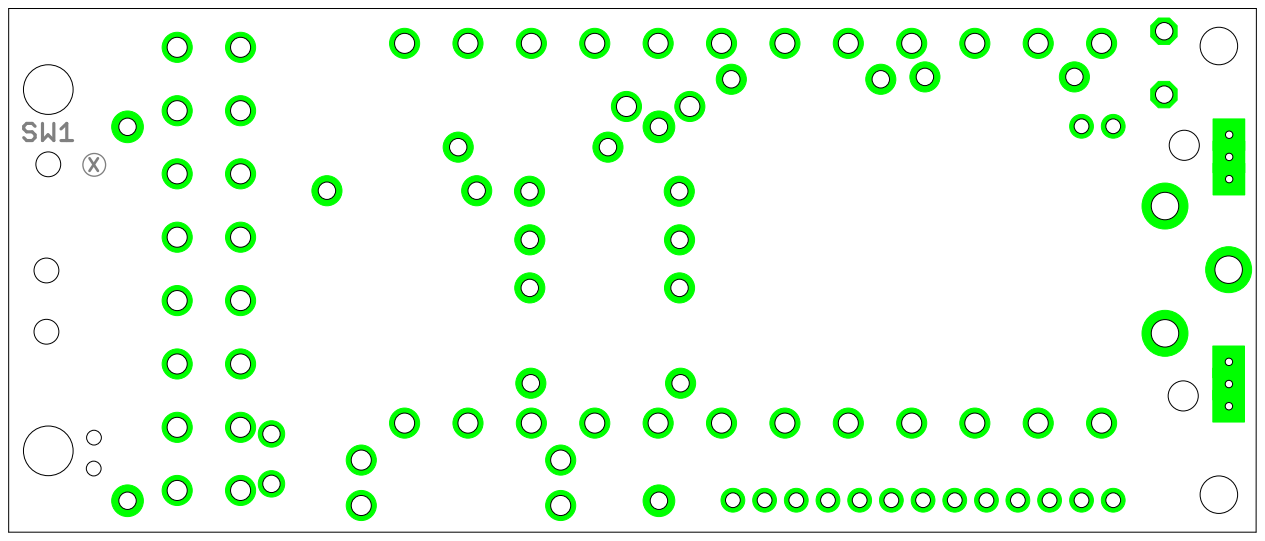
[picture p54: page 1]
