The0ldM0nk/Locator2/Board/Locator2 PCB Top 230417.pdf

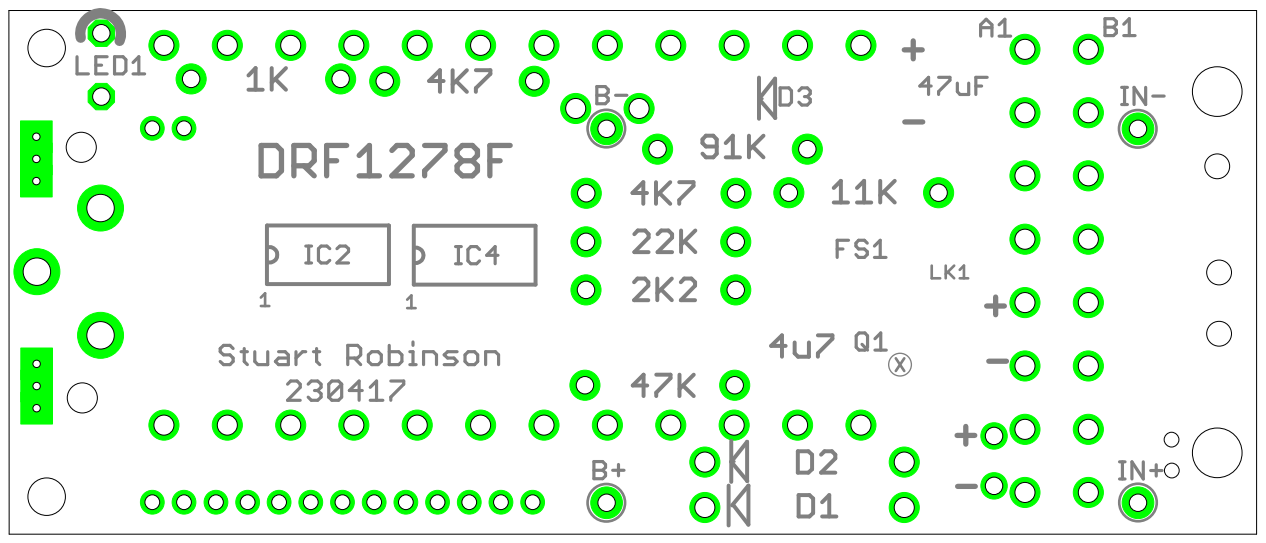
[picture p55: page 1]
