The0ldM0nk/Locator2/Programs/Locator2_Transmitter_171117/Locator2_Transmitter_Settings.h

//Location1_Settings.h
/*
******************************************************************************************************

  LoRaTracker Programs for Arduino

  Copyright of the author Stuart Robinson - 09/11/2017

  http://www.LoRaTracker.uk

  These programs may be used free of charge for personal, recreational and educational purposes only.

  This program, or parts of it, may not be used for or in connection with any commercial purpose without
  the explicit permission of the author Stuart Robinson.

  The programs are supplied as is, it is up to individual to decide if the programs are suitable for the
  intended purpose and free from errors.

  To Do:

  Changes:


******************************************************************************************************
*/

//**************************************************************************************************
// 1) Hardware related definitions and options - specify board type here
//**************************************************************************************************
#define External_VoltageRead                             //read battery voltage from resistor divider  
#define Board_Definition "Locator2_Board_Definitions.h"  //define the board to use here       

//**************************************************************************************************
// 2) Program Options
//**************************************************************************************************


#define ConfigureDefaults                    //Configure settings from default program constants, save in memory and copy to RAM, need to do this once only
//#define ConfigureFromMemory                //Read settings from attached memory
//#define ClearAllMemory                     //Clears from start memory to end memory, normally 1kbyte, needs to be followed by ConfigureDefaults
//#define ClearSavedData                     //zero the saved data, resets, sequence, Mahr


#define CheckTone                            //comment in to have a calibrate tone at startup, also indicates navigation model 6 set for UBlox GPS

//#define DEBUG                              //if defined, prints additional debug information to terminal

//#define AllowRemoteControl                 //if you want to be able to remote control tracker, set this option

//**************************************************************************************************
// 3) Frequency settings
//**************************************************************************************************

//Tracker mode
const unsigned long TrackerMode_Frequency = 434400000;

//Search mode
const unsigned long SearchMode_Frequency = 434400000;

//Command mode
const unsigned long CommandMode_Frequency = 434400000;

//Bind mode - Change this with great care !!!!!
const unsigned long BindMode_Frequency = 434100000;

//this is the LoRa module frequency calibration offset in Hertz
const int CalibrationOffset = 0;


//**************************************************************************************************
// 4) LoRa settings
//**************************************************************************************************

//Tracker mode
#define TrackerMode_Bandwidth BW62500
#define TrackerMode_SpreadingFactor SF8
#define TrackerMode_CodeRate CR45
#define TrackerMode_Power 10

//Search mode
#define SearchMode_Bandwidth BW62500
#define SearchMode_SpreadingFactor SF12
#define SearchMode_CodeRate CR45
#define SearchMode_Power 10

//Command mode
#define CommandMode_Bandwidth BW62500
#define CommandMode_SpreadingFactor SF10
#define CommandMode_CodeRate CR45
#define CommandMode_Power 10

//Bind mode
#define BindMode_Bandwidth BW500000
#define BindMode_SpreadingFactor SF8
#define BindMode_CodeRate CR45
#define BindMode_Power 2

#define SendBind                             //at startup tracker transmitter will send a bind packet
//#define LORADEBUG                          //displays extra debug messages when using LoRa

const byte Deviation = 0x52;                 //typical deviation for tones
const byte lora_RXBUFF_Size = 32;            //locator does not use large packets 
const byte lora_TXBUFF_Size = 64;


const int inter_Packet_delay = 500;          //allows time for receiver to be ready to see a possible reply, in mS

const byte Cmd_WaitSecs = 5;                 //number of seconds to stay in waiting for command mode
const byte Command_Loops = 3;                //if one command is received wait for this number of loops to keep control channel open

//Key Definition
const char key0 = 'L';                       //Used to restrict access to some commands
const char key1 = 'o';
const char key2 = 'R';
const char key3 = 'a';

//**************************************************************************************************
// 5) GPS Options - Note GPSHotfix option is set in section 11
//**************************************************************************************************

#define USE_SOFTSERIAL_GPS                       //need to include this if we are using softserial for GPS     
#define GPS_Library "UBLOX_SerialGPS2.h"         //define the GPS library routines to use here
//#define GPS_ALLOW_GPGSV                        //define this so that GPGSV senetences are not turned off 

//#define DEBUGNoGPS                               //test mode, does not use GPS
//#define Use_Test_Location                        //to use test location for transmissions include this define
//#define GPS_ALLOW_GPGSV                          //define this so that GPGSV are seen 

#define GPSBaud 9600                             //GPS Baud rate   
#define WhenNoGPSFix LeaveOn                     //What to do with GPS power when there is no fix at ends of wait period (LeaveOn or LeaveOff)
#define WaitGPSFixSeconds 30                     //in flight mode time to wait for a new GPS fix 
#define Remove_GPS_Power                         //Some tracker boards can remove the power from the GPS, if so define this to use it
//#define Use_GPS_SoftwareBackup                   //some GPSs do not support this mode, Ubloxes do, used for GPS Hotfix option


const unsigned long GPS_WaitAck_mS = 2000;       //number of mS to wait for an ACK response from GPS
const unsigned int GPSFixs = 100;                //number of GPS fixes between setting system clock from GPS
const byte GPS_attempts = 10;                    //number of times the sending of GPS config will be attempted.
const byte GPS_Reply_Size = 12;                  //size of GPS reply buffer
const unsigned int GPS_Clear_DelaymS = 2000;     //mS to wait after a GPS Clear command is sent            

//Centre of Cardiff Castle keep
#define TestLatitude 51.48230                    //5128.938,N 
#define TestLongitude -3.18136                   //00310.8816,W 
#define TestAltitude 48


/*
  Passive GPS station: Swanbridge - C1ST1667
  https://www.ordnancesurvey.co.uk/gps/legacy-control-information/C1ST1667
  N 51 23'59.105955", W 3 11',47.413031
  51.399751654166664, -3.196503619722222

  #define TestLatitude 51.399752
  #define TestLongitude -3.196504
  #define TestAltitude 0
*/

//**************************************************************************************************
// 6) Which Memory to use for storage
//**************************************************************************************************

//#define Use_EEPROM_Only                               //if program used on board without FRAM, this option needs to be defined.    
#define Memory_Library "I2CFRAM_MB85RC16PNF.h"          //define this file if the I2C FRAM is in use


//****************************************************************************************************
// 11) Program Default Option settings
//    This section determines which options are on or off by default, this is the Default_config1 byte
//    Take care here..........
//**************************************************************************************************

#define OptionOff 0
#define OptionOn 1

const char option_SearchEnable = OptionOn;
const char option_TXEnable = OptionOn;
const char option_FSKRTTYEnable = OptionOn;
const char option_CheckFence = OptionOff;
const char option_ShortPayloadEnable = OptionOff;
const char option_RepeatEnable = OptionOff;
const char option_AddressStrip = OptionOn;
const char option_GPSHotFix = OptionOff;

#define option_SearchEnable_SUM (option_SearchEnable*1)
#define option_TXEnable_SUM (option_TXEnable*2)
#define option_FSKRTTYEnable_SUM (option_FSKRTTYEnable*4)
#define option_CheckFence_SUM (option_CheckFence*8)
#define option_ShortPayloadEnable_SUM (option_ShortPayloadEnable*16)
#define option_RepeatEnable_SUM (option_RepeatEnable*32)
#define option_AddressStrip_SUM (option_AddressStrip*64)
#define option_GPSHotFix_SUM (option_GPSHotFix*128)

//See Program_Definitions.h in the LoRaTracker library for details, the above options translate into Default_config1 byte of 1 + 2 + 4 + 64 = 71

const unsigned int Default_config1 = (option_SearchEnable_SUM + option_TXEnable_SUM + option_FSKRTTYEnable_SUM + option_CheckFence_SUM + option_ShortPayloadEnable_SUM + option_RepeatEnable_SUM + option_AddressStrip_SUM + option_GPSHotFix_SUM);
//const unsigned int Default_config1 = 71;         //Phew, the default config can always be set manually .............


//**************************************************************************************************
// 15) Locator settings
//**************************************************************************************************


#define EnableTimeout
//#define EnableRCPulseCheck

const unsigned int Loop_Sleepsecs = 10;                 //sleep time in seconds after each TX loop
const boolean  promiscuous_Mode = true;                 //if set to True remote control packets from any node accepted


#define RemoteControlNode 'G'                           //normally used by tracker transmitter in promiscuous_Mode
#define ControlledNode '1'                              //normally used by tracker transmitter in promiscuous_Mode
#define ThisNode ControlledNode

const unsigned int pulseerrorlimit = 150;               //error count needed to trigger lost condition
const unsigned int holddifference = 100;                //if differance between two RC pulses is less than these uS, then hold is assumed
const unsigned int RCpulseshort = 750;                  //in uS, lower than this RC pulse is assumed not to be valid
const unsigned int RCpulselong = 2500;                  //in uS, higher than this RC pulse is assumed not to be valid
const byte inc_on_pulse_error = 15;                     //number to increase pulse error count on a not valid pulse
const byte dec_on_pulse_OK = 10;                        //number to decrease pulse error count on a valid pulse

const unsigned int MinsToLost = 40;                     //minutes before lost mode automatically engaged.
const unsigned int TXLostDelaySecs = 20;                //delay in seconds between lost mode transmissions

const int lostclear_CheckmS = 2000;                     //mS to wait for reset during lost clear operation 
