The0ldM0nk/Locator2/(commit log)

2017-07-10 Intial Build of Locator2 repository
    [LoRaTracker Locator2 230417.xls]
2017-07-24 Updated build instructions, added kit list and pictures
    [LoRaTracker Locator2 230417.xls, Locator2 Kit Contents.xls]
2017-09-12 Changes to document board dated 270617
2017-09-13 Changes to board default type
2017-10-12 Change to I2C Scanner, added file
2017-10-25 Correct typo in kit list
    [Locator2 Kit Contents.xls]
2018-01-25 Added Locator2 for RFM9X Schematic and PCB
